Kingdragoncat/PrintBridge/BOM.csv

Reference | Qty | Value | LCSC Part # | Package | Description | Unit Price | Subtotal | Link
U1 | 1 | ESP32-S3-WROOM-1-N8 | C2913198 | Module | ESP32-S3 WiFi/BLE module (8MB flash) | $2.88 | $2.88 | https://www.lcsc.com/product-detail/C2913198.html
USB1 | 1 | USB-A-F-90 | C168708 | Through-hole | USB-A host receptacle (to printer) | $0.15 | $0.15 | https://www.lcsc.com/product-detail/C168708.html
J2 | 1 | TYPE-C-31-M-12 | C165948 | SMD | USB-C power input (5V only) | $0.10 | $0.10 | https://www.lcsc.com/product-detail/C165948.html
U2 | 1 | AMS1117-3.3 | C6186 | SOT-223 | 3.3V linear regulator | $0.05 | $0.05 | https://www.lcsc.com/product-detail/C6186.html
SW1, SW2 | 2 | TS-1187A-B-A-B | C318884 | SMD | Tactile switch (BOOT + RESET) | $0.02 | $0.04 | https://www.lcsc.com/product-detail/C318884.html
J1 | 1 | Micro_SD_Card (DM3AT-SF-PEJM5) | C114218 | SMD | Micro SD card connector | $0.65 | $0.65 | https://www.lcsc.com/product-detail/C114218.html
D1 | 1 | WS2812B | C2761795 | 5050 | Addressable RGB status LED | $0.08 | $0.08 | https://www.lcsc.com/product-detail/C2761795.html
R1, R2 | 2 | 10k | C269742 | 0805 | Pull-up resistors (EN + BOOT) | $0.01 | $0.02 | https://www.lcsc.com/product-detail/C269742.html
R3, R4 | 2 | 5.1k | C269748 | 0805 | USB-C CC1/CC2 pull-down resistors | $0.01 | $0.02 | https://www.lcsc.com/product-detail/C269748.html
C1, C3 | 2 | 100nF | C38141 | 0805 | Ceramic decoupling capacitors | $0.01 | $0.02 | https://www.lcsc.com/product-detail/C38141.html
C2 | 1 | 10uF | C92341 | 0805 | Ceramic bulk capacitor (3V3 rail) | $0.02 | $0.02 | https://www.lcsc.com/product-detail/C92341.html
C4 | 1 | 10uF | C92341 | 0805 | Ceramic bulk capacitor (SD card) | $0.02 | $0.02 | https://www.lcsc.com/product-detail/C92341.html
F1 | 1 | Polyfuse 500mA | C106264 | 1206 | PTC resettable fuse (USB-C 5V in) | $0.07 | $0.07 | https://www.lcsc.com/product-detail/C106264.html
J3 | 1 | Conn_01x04 | — | 2.54mm | UART pin header (for flashing) | $0.05 | $0.05 | https://www.lcsc.com/search?q=1x4+2.54mm+pin+header
 |  |  |  |  | TOTAL (18 parts) |  | $4.17
