Kingdragoncat/PrintBridge/hardware/production/bom.csv

Designator | Footprint | Quantity | Value | LCSC Part #
C1, C3 | 0805 | 2 | 100nF
C2 | 0805 | 1 | 10 uF
C4 | 0805 | 1 | 10uF
D1 | LED_WS2812B_PLCC4_5.0x5.0mm_P3.2mm | 1 | WS2812B
F1 | 1206 | 1 | Polyfuse
J1 | microSD_HC_Hirose_DM3AT-SF-PEJM5 | 1 | Micro_SD_Card
J2 | USB-C_SMD-TYPE-C-31-M-12_1 | 1 | TYPE-C-31-M-12 | C165948
J3 | PinSocket_1x04_P2.54mm_Vertical | 1 | Conn_01x04
R1, R2 | 0805 | 2 | 10k
R3, R4 | 0805 | 2 | 5.1k
SW1, SW2 | SW-SMD_4P-L5.1-W5.1-P3.70-LS6.5-TL_H1.5 | 2 | TS-1187A-B-A-B | C318884
U1 | ESP32-S3-WROOM-1 | 1 | ESP32-S3-WROOM-1
U2 | SOT-223-3_L6.5-W3.4-P2.30-LS7.0-BR | 1 | AMS1117-3.3 | C6186
USB1 | USB-A-TH_C168708 | 1 | USB-A-F-90 | C168708
