Kingdragoncat/PrintBridge/hardware/PrintBridge.kicad_pcb

## KiCad design hardware/PrintBridge.kicad_pcb (2026-10-30)

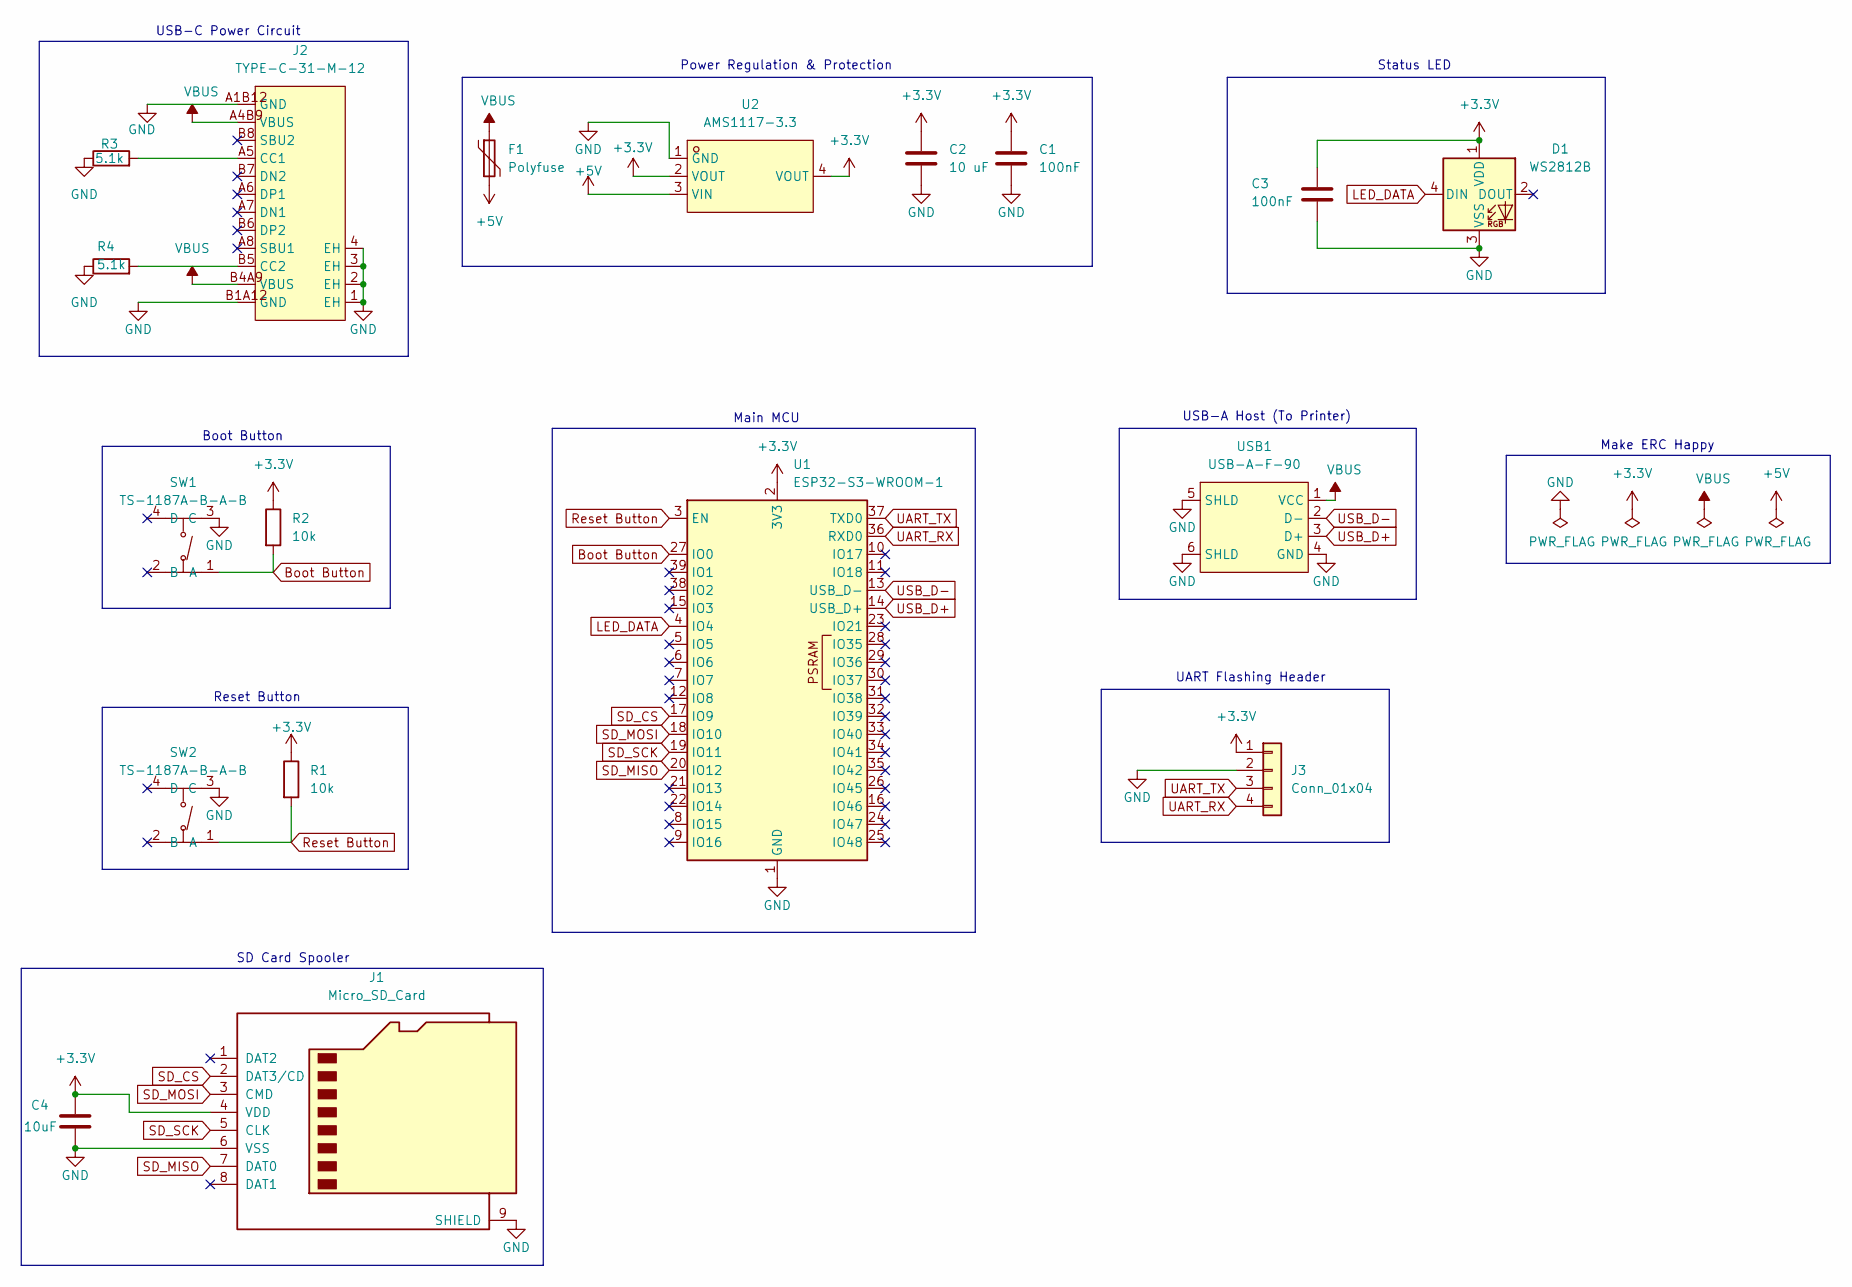
[picture p6: schematic PrintBridge.kicad_sch]

Parts:
C1, C3: 100nF; C_0805_2012Metric_Pad1.18x1.45mm_HandSolder
C2: 10 uF; C_0805_2012Metric_Pad1.18x1.45mm_HandSolder
C4: 10uF; C_0805_2012Metric_Pad1.18x1.45mm_HandSolder
D1: WS2812B; LED_WS2812B_PLCC4_5.0x5.0mm_P3.2mm
F1: Polyfuse; Fuse_1206_3216Metric_Pad1.42x1.75mm_HandSolder
J1: Micro_SD_Card; microSD_HC_Hirose_DM3AT-SF-PEJM5
J2: TYPE-C-31-M-12; USB-C_SMD-TYPE-C-31-M-12_1; MPN TYPE-C-31-M-12; LCSC Part C165948
J3: Conn_01x04; PinSocket_1x04_P2.54mm_Vertical
R1, R2: 10k; R_0805_2012Metric_Pad1.20x1.40mm_HandSolder
R3, R4: 5.1k; R_0805_2012Metric_Pad1.20x1.40mm_HandSolder
SW1, SW2: TS-1187A-B-A-B; SW-SMD_4P-L5.1-W5.1-P3.70-LS6.5-TL_H1.5; MPN TS-1187A-B-A-B; LCSC Part C318884
U1: ESP32-S3-WROOM-1
U2: AMS1117-3.3; SOT-223-3_L6.5-W3.4-P2.30-LS7.0-BR; MPN AMS1117-3.3; LCSC Part C6186
USB1: USB-A-F-90; USB-A-TH_C168708; MPN A/F90度外扣铜壳鱼叉脚无卷边加高9.3白胶PBT 不耐高温; LCSC Part C168708

Connections:
+3.3V: C1.1, C2.1, C3.1, C4.1, D1.1 (VDD), J1.4 (VDD), J3.1, R1.1, R2.1, U1.2 (3V3), U2.2 (VOUT), U2.4 (VOUT)
+5V: F1.2, U2.3 (VIN)
Boot Button: R2.2, SW1.1 (A), U1.27 (IO0)
GND: C1.2, C2.2, C3.2, C4.2, D1.3 (VSS), J1.6 (VSS), J1.9 (SHIELD), J2.1 (EH), J2.2 (EH), J2.3 (EH), J2.4 (EH), J2.A1B12 (GND), J2.B1A12 (GND), J3.2, R3.1, R4.1, SW1.3 (C), SW2.3 (C), U1.1 (GND), U1.40 (GND), U1.41 (GND), U2.1 (GND), USB1.4 (GND), USB1.5 (SHLD), USB1.6 (SHLD)
LED_DATA: D1.4 (DIN), U1.4 (IO4)
unnamed: J2.A5 (CC1), R3.2
unnamed: J2.B5 (CC2), R4.2
Reset Button: R1.2, SW2.1 (A), U1.3 (EN)
SD_CS: J1.2 (DAT3/CD), U1.17 (IO9)
SD_MISO: J1.7 (DAT0), U1.20 (IO12)
SD_MOSI: J1.3 (CMD), U1.18 (IO10)
SD_SCK: J1.5 (CLK), U1.19 (IO11)
UART_RX: J3.4, U1.36 (RXD0)
UART_TX: J3.3, U1.37 (TXD0)
USB_D+: U1.14 (USB_D+), USB1.3 (D+)
USB_D-: U1.13 (USB_D-), USB1.2 (D-)
VBUS: F1.1, J2.A4B9 (VBUS), J2.B4A9 (VBUS), USB1.1 (VCC)

Notes on the sheet:
Reset Button
UART Flashing Header
Boot Button
SD Card Spooler
Main MCU
Power Regulation & Protection
Status LED
USB-A Host (To Printer)
Make ERC Happy
USB-C Power Circuit

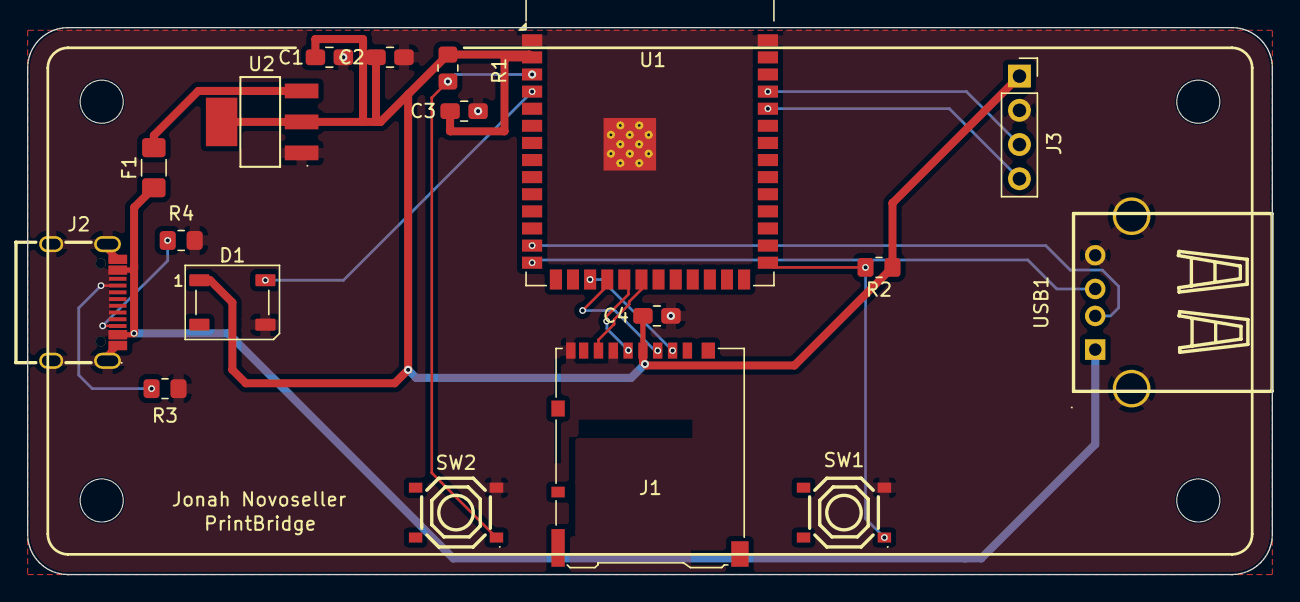
[picture p7: board PrintBridge.kicad_pcb from above]

Board: 2 copper layers, 92.4 x 40.6 mm, 18 parts (0 on the bottom side), 17 nets.
