Kingdragoncat/PrintBridge/(commit log)

2026-08-26 Initial commit for PrintBridge
    [BOM.csv, PrintBridge.kicad_pcb, PrintBridge.kicad_sch, bom.csv, designators.csv, freerouting.dsn, positions.csv]
2026-09-16 Add firmware, LCSC links for all parts, replace espressif repo with links, clean up
    [BOM.csv, PrintBridge.kicad_pcb, freerouting.dsn]
2026-09-21 PCB rework: fix J2 connector clearance/hole-clearance DRC errors, merge updated cap placement + rounded corners + silkscreen art, clean up routing corner, fix silkscreen/copper clash near top edge
    [PrintBridge.kicad_pcb, PrintBridge.kicad_sch, bom.csv, designators.csv, positions.csv]
2026-10-30 Update firmware: USB printer host driver, web dashboard, queue manager, OTA, and remote gateway
    [PrintBridge.kicad_pcb, positions.csv]
